PTDreamer/FrequencyCounter/docs/A Low Power, Low Cost, Differential Input to a Single-Ended Output Amplifier _ Analog Devices_files/raq-issue-145.jpg

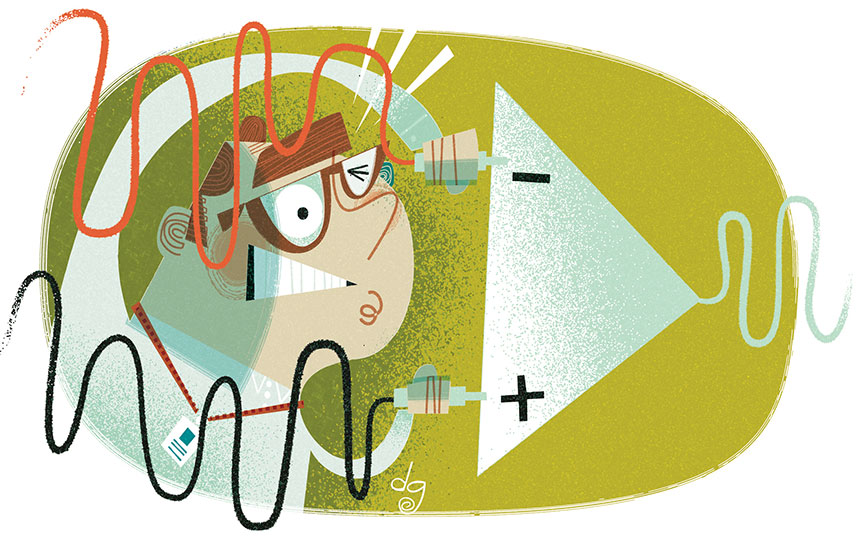
docs/A Low Power, Low Cost, Differential Input to a Single-Ended Output Amplifier _ Analog Devices_files/raq-issue-145.jpg
