PTDreamer/FrequencyCounter/docs/A Low Power, Low Cost, Differential Input to a Single-Ended Output Amplifier _ Analog Devices_files/jordyn-rombola.jpg

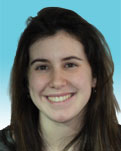
docs/A Low Power, Low Cost, Differential Input to a Single-Ended Output Amplifier _ Analog Devices_files/jordyn-rombola.jpg
