PTDreamer/FrequencyCounter/3D/0476Series_LTF.step

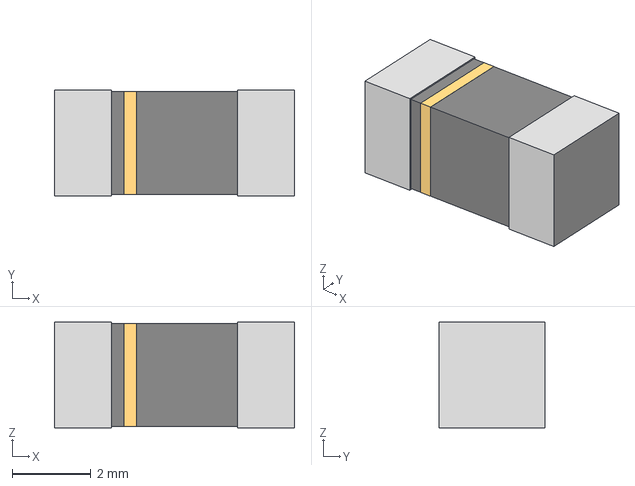
[picture p10: CAD file, 2021-09-11]
3D/0476Series_LTF.step
6.10 x 2.69 x 2.69 mm
