PTDreamer/FrequencyCounter/KiCAD_symbols3/eec.models/Analog_Devices_Inc_-_HMC624ALP4E.step

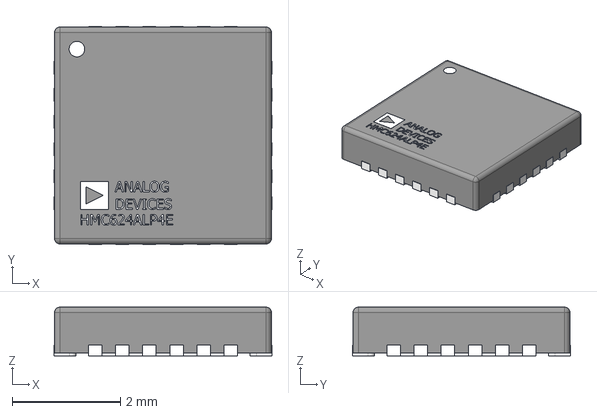
[picture p11: CAD file, 2021-09-11]
KiCAD_symbols3/eec.models/Analog_Devices_Inc_-_HMC624ALP4E.step
4.02 x 4.02 x 0.902 mm
