PTDreamer/FrequencyCounter/onsemi/eec.models/ON_Semiconductor_-_NC7SZ04M5X.step

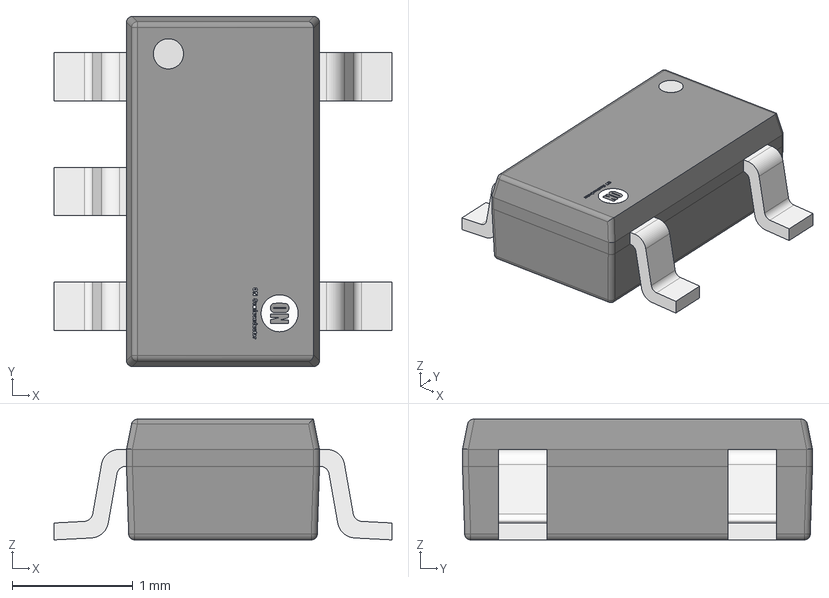
[picture p12: CAD file, 2021-09-11]
onsemi/eec.models/ON_Semiconductor_-_NC7SZ04M5X.step
2.80 x 2.90 x 1.00 mm
IC_BODY
IC_LEG x 5
circle
ON Semiconductor
