PTDreamer/FrequencyCounter/3D/SOT-223_5MC_MCH-L.step

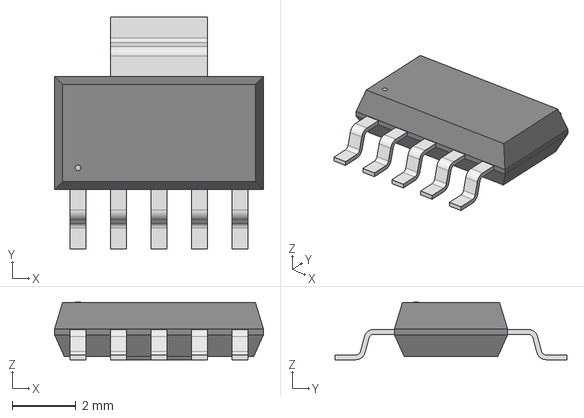
[picture p13: CAD file, 2021-09-11]
3D/SOT-223_5MC_MCH-L.step
6.55 x 7.26 x 1.80 mm
