PTDreamer/FrequencyCounter/3D/OCXO.step

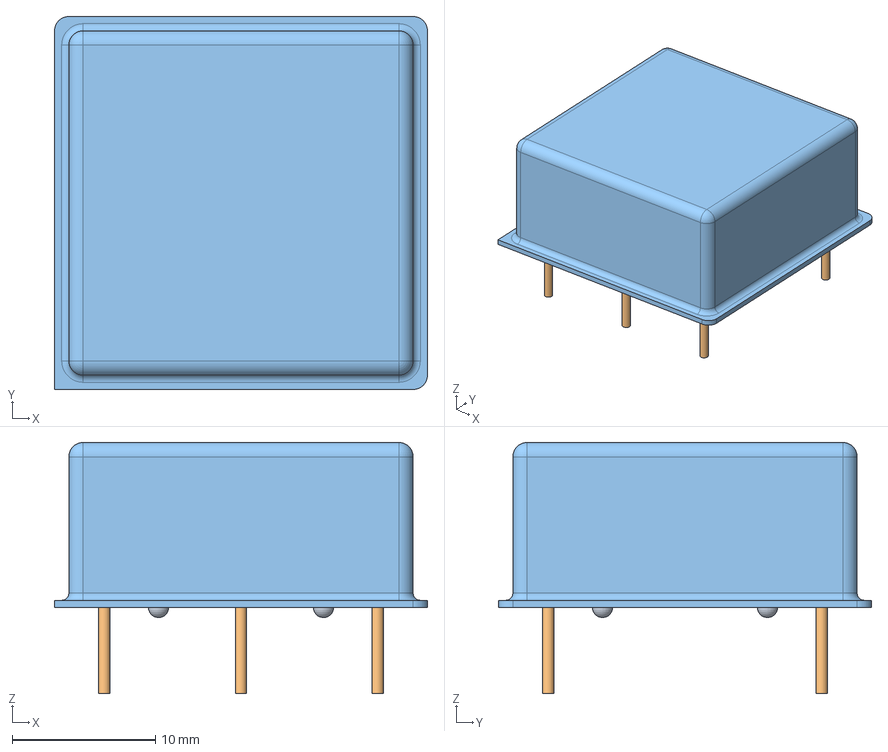
[picture p14: CAD file, 2021-09-11]
3D/OCXO.step
26.0 x 26.0 x 17.5 mm
