PTDreamer/FrequencyCounter/3D/ADL5385 in LFCSP 24 case.SLDPRT

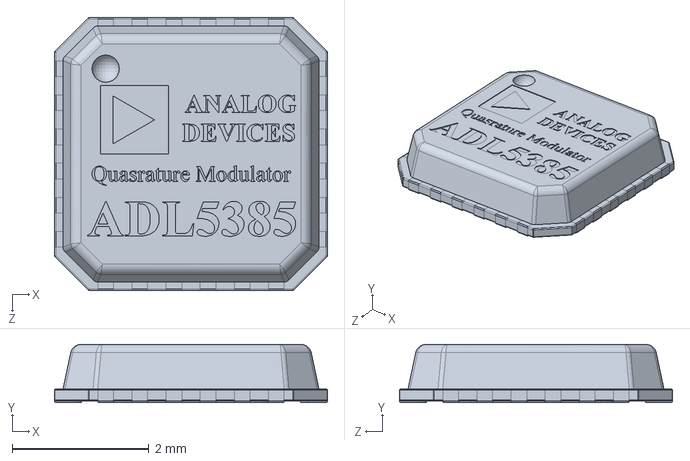
[picture p15: CAD file, 2021-09-11]
3D/ADL5385 in LFCSP 24 case.SLDPRT
4.00 x 0.85 x 4.00 mm
