PTDreamer/FrequencyCounter/3D/SMA_Board_Edge_Molex_732511150.step

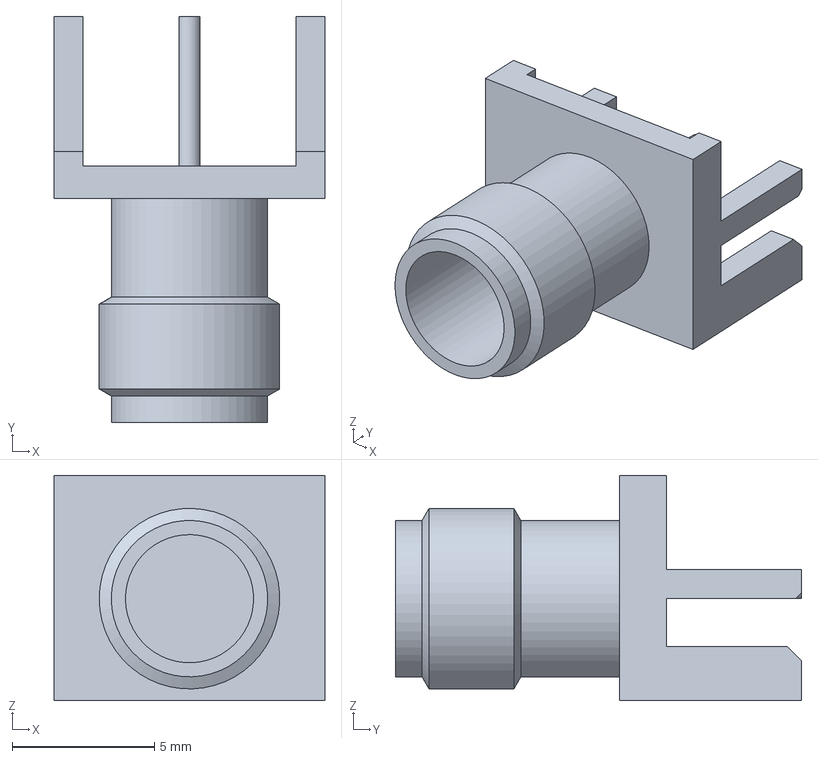
[picture p16: CAD file, 2021-09-11]
3D/SMA_Board_Edge_Molex_732511150.step
9.53 x 14.3 x 7.93 mm
