PTDreamer/FrequencyCounter/(list of files, cad)

Other CAD files:
3D/0476Series_LTF-M.step
3D/0476Series_LTF-L.step
3D/SOT-223_5MC_MCH-M.step
3D/SOT-223_5MC_MCH.step
3D/SMA_Board_Edge_Molex_732511150.fcstd
3D/SMA_Board_Edge_Molex_732511150.obj
3D/SMA_Board_Edge_Molex_732511150.stl
