PTDreamer/FrequencyCounter/docs/A Low Power, Low Cost, Differential Input to a Single-Ended Output Amplifier _ Analog Devices_files/raq-issue-145-fig-02.png

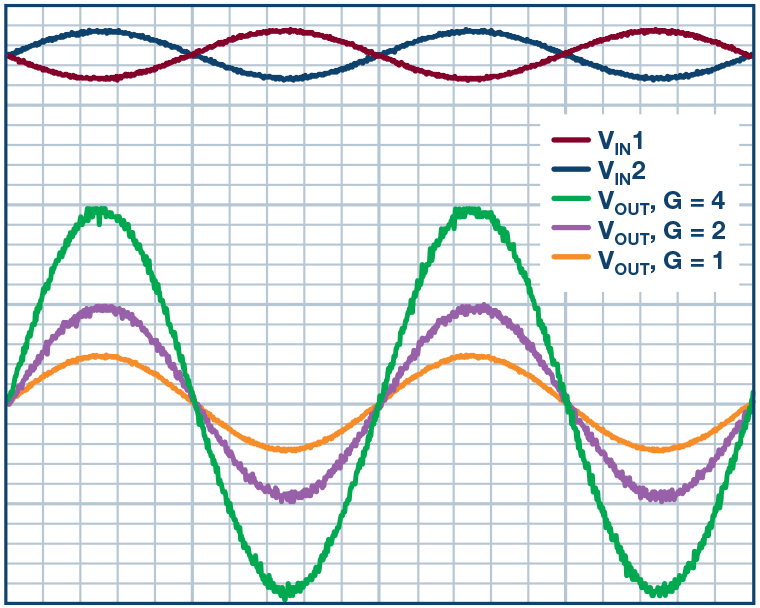
docs/A Low Power, Low Cost, Differential Input to a Single-Ended Output Amplifier _ Analog Devices_files/raq-issue-145-fig-02.png
