PTDreamer/FrequencyCounter/FrequencyCounter.kicad_pcb

## KiCad design FrequencyCounter.kicad_pcb (2021-09-11)

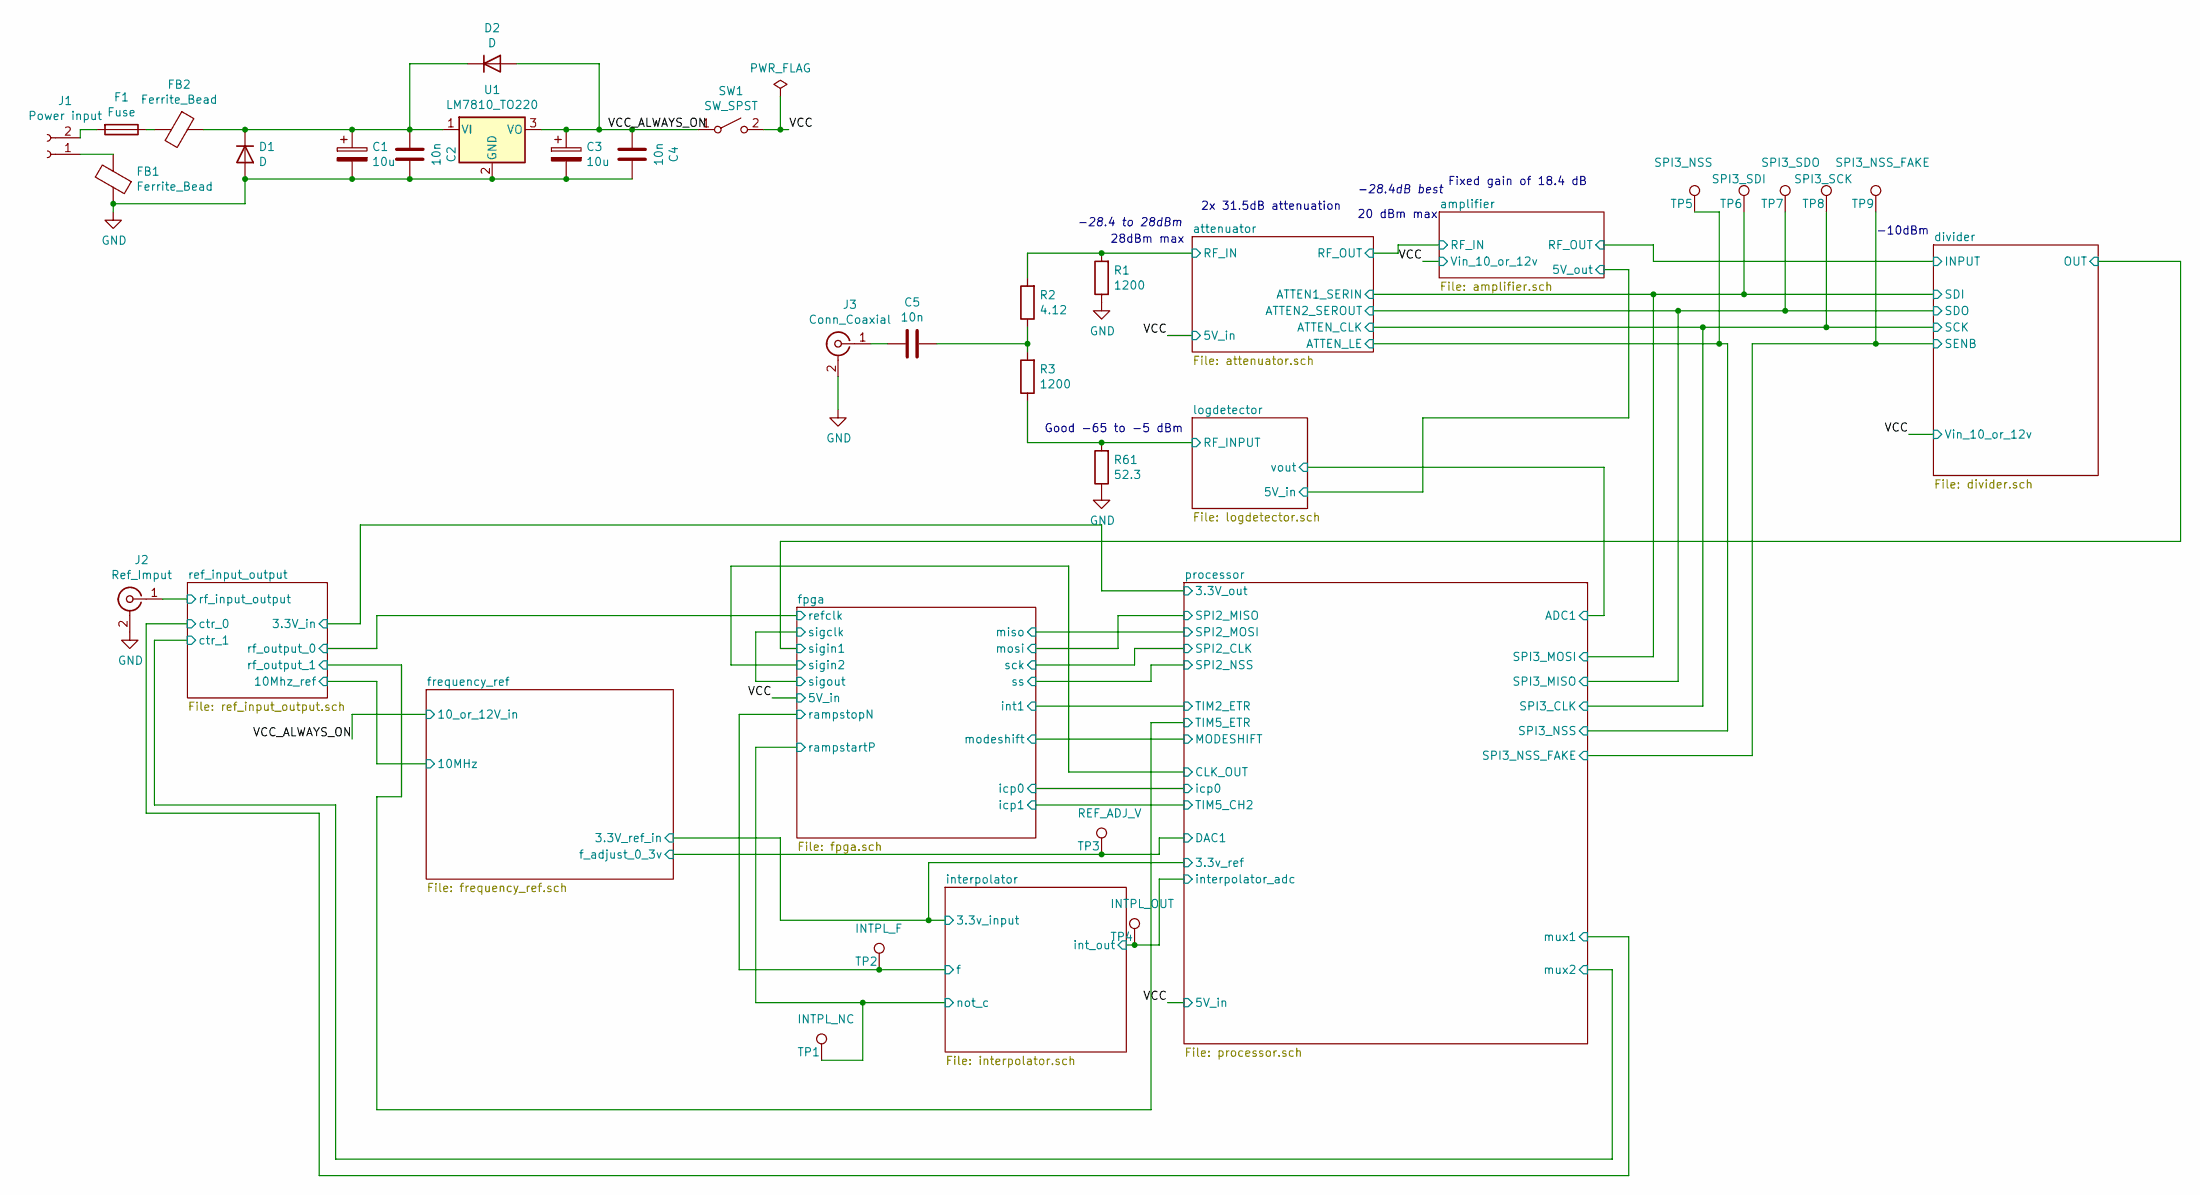
[picture p20: schematic FrequencyCounter.sch]

Parts:
C1, C3: 10u; CP_Radial_D5.0mm_P2.00mm
C2, C4: 10n; C_0805_2012Metric_Pad1.15x1.40mm_HandSolder
C5: 10n; C_0402_1005Metric
D1, D2: D; D_SOD-123
F1: Fuse; Fuseholder_Littelfuse_Nano2_157x
FB1, FB2: Ferrite_Bead; L_0805_2012Metric_Pad1.15x1.40mm_HandSolder
J1: Power input; PhoenixContact_MC_1,5_2-G-5.08_1x02_P5.08mm_Horizontal
J2: Ref_Imput; SMA_Amphenol_132289_EdgeMount
J3: Conn_Coaxial; SMA_Amphenol_132289_EdgeMount
R1, R3: 1200; R_0402_1005Metric
R2: 4.12; R_0402_1005Metric
R61: 52.3; R_0402_1005Metric
SW1: SW_SPST; PinSocket_1x02_P2.54mm_Vertical
TP1: INTPL_NC; TestPoint_Pad_D2.0mm
TP2: INTPL_F; TestPoint_Pad_D2.0mm
TP3: REF_ADJ_V; TestPoint_Pad_D2.0mm
TP4: INTPL_OUT; TestPoint_Pad_D2.0mm
TP5: SPI3_NSS; TestPoint_Pad_D2.0mm
TP6: SPI3_SDI; TestPoint_Pad_D2.0mm
TP7: SPI3_SDO; TestPoint_Pad_D2.0mm
TP8: SPI3_SCK; TestPoint_Pad_D2.0mm
TP9: SPI3_NSS_FAKE; TestPoint_Pad_D2.0mm
U1: LM7810_TO220; TO-220-3_Vertical

Connections:
/VCC: SW1.2 (B); also elsewhere on the board
/VCC_ALWAYS_ON: C3.1, C4.1, D2.2 (A), SW1.1 (A), U1.3 (VO); also elsewhere on the board
/attenuator/ATTEN1_SERIN: TP6.1; also elsewhere on the board
/attenuator/ATTEN2_SEROUT: TP7.1; also elsewhere on the board
/attenuator/ATTEN_CLK: TP8.1; also elsewhere on the board
/attenuator/ATTEN_LE: TP5.1; also elsewhere on the board
/attenuator/RF_IN: R1.2, R2.2; also elsewhere on the board
/divider/SENB: TP9.1; also elsewhere on the board
/interpolator/f: TP2.1; also elsewhere on the board
/interpolator/int_out: TP4.1; also elsewhere on the board
/interpolator/not_c: TP1.1; also elsewhere on the board
/logdetector/RF_INPUT: R3.1, R61.2; also elsewhere on the board
/processor/DAC1: TP3.1; also elsewhere on the board
/ref_input_output/rf_input_output: J2.1 (In); also elsewhere on the board
GND: C1.2, C2.2, C3.2, C4.2, D1.2 (A), FB1.1, J2.2 (Ext), J3.2 (Ext), R1.1, R61.1, U1.2 (GND); also elsewhere on the board
unnamed: C1.1, C2.1, D1.1 (K), D2.1 (K), FB2.1, U1.1 (VI)
unnamed: C5.1, J3.1 (In)
unnamed: C5.2, R2.1, R3.2
unnamed: F1.1, FB2.2
unnamed: F1.2, J1.2
unnamed: FB1.2, J1.1

Notes on the sheet:
28dBm max
20 dBm max
-10dBm
Good -65 to -5 dBm
2x 31.5dB attenuation
Fixed gain of 18.4 dB
-28.4dB best
-28.4 to 28dBm

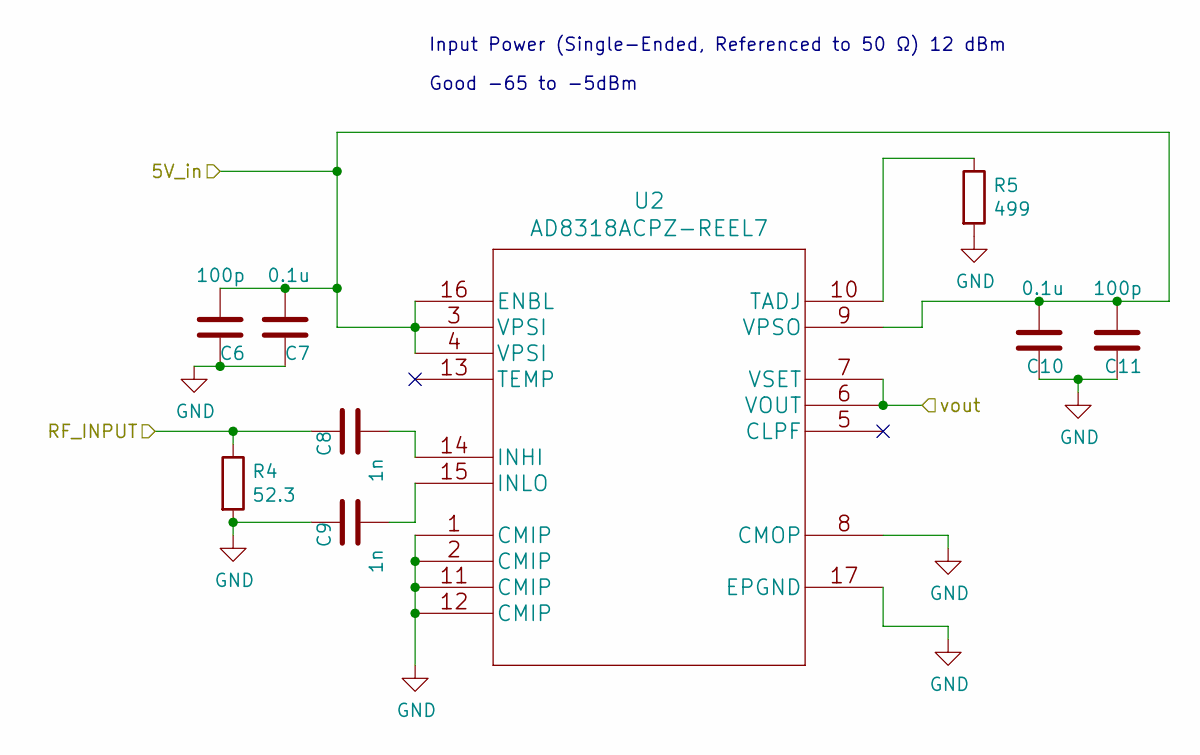
[picture p21: schematic logdetector.sch]

Parts:
C6, C11: 100p; C_0603_1608Metric_Pad1.05x0.95mm_HandSolder
C7, C10: 0.1u; C_0805_2012Metric_Pad1.15x1.40mm_HandSolder
C8, C9: 1n; C_0402_1005Metric
R4: 52.3; R_0402_1005Metric
R5: 499; R_0805_2012Metric_Pad1.15x1.40mm_HandSolder
U2: AD8318ACPZ-REEL7

Connections:
/logdetector/5V_in: C6.2, C7.2, C10.2, C11.2, U2.3 (VPSI), U2.4 (VPSI), U2.9 (VPSO), U2.16 (ENBL); also elsewhere on the board
/logdetector/RF_INPUT: C8.1, R4.1; also elsewhere on the board
/processor/ADC1: U2.6 (VOUT), U2.7 (VSET); also elsewhere on the board
GND: C6.1, C7.1, C9.1, C10.1, C11.1, R4.2, R5.2, U2.1 (CMIP), U2.2 (CMIP), U2.8 (CMOP), U2.11 (CMIP), U2.12 (CMIP), U2.17 (EPGND); also elsewhere on the board
unnamed: C8.2, U2.14 (INHI)
unnamed: C9.2, U2.15 (INLO)
unnamed: R5.1, U2.10 (TADJ)

Notes on the sheet:
Input Power (Single-Ended, Referenced to 50 Ω) 12 dBm
Good -65 to -5dBm

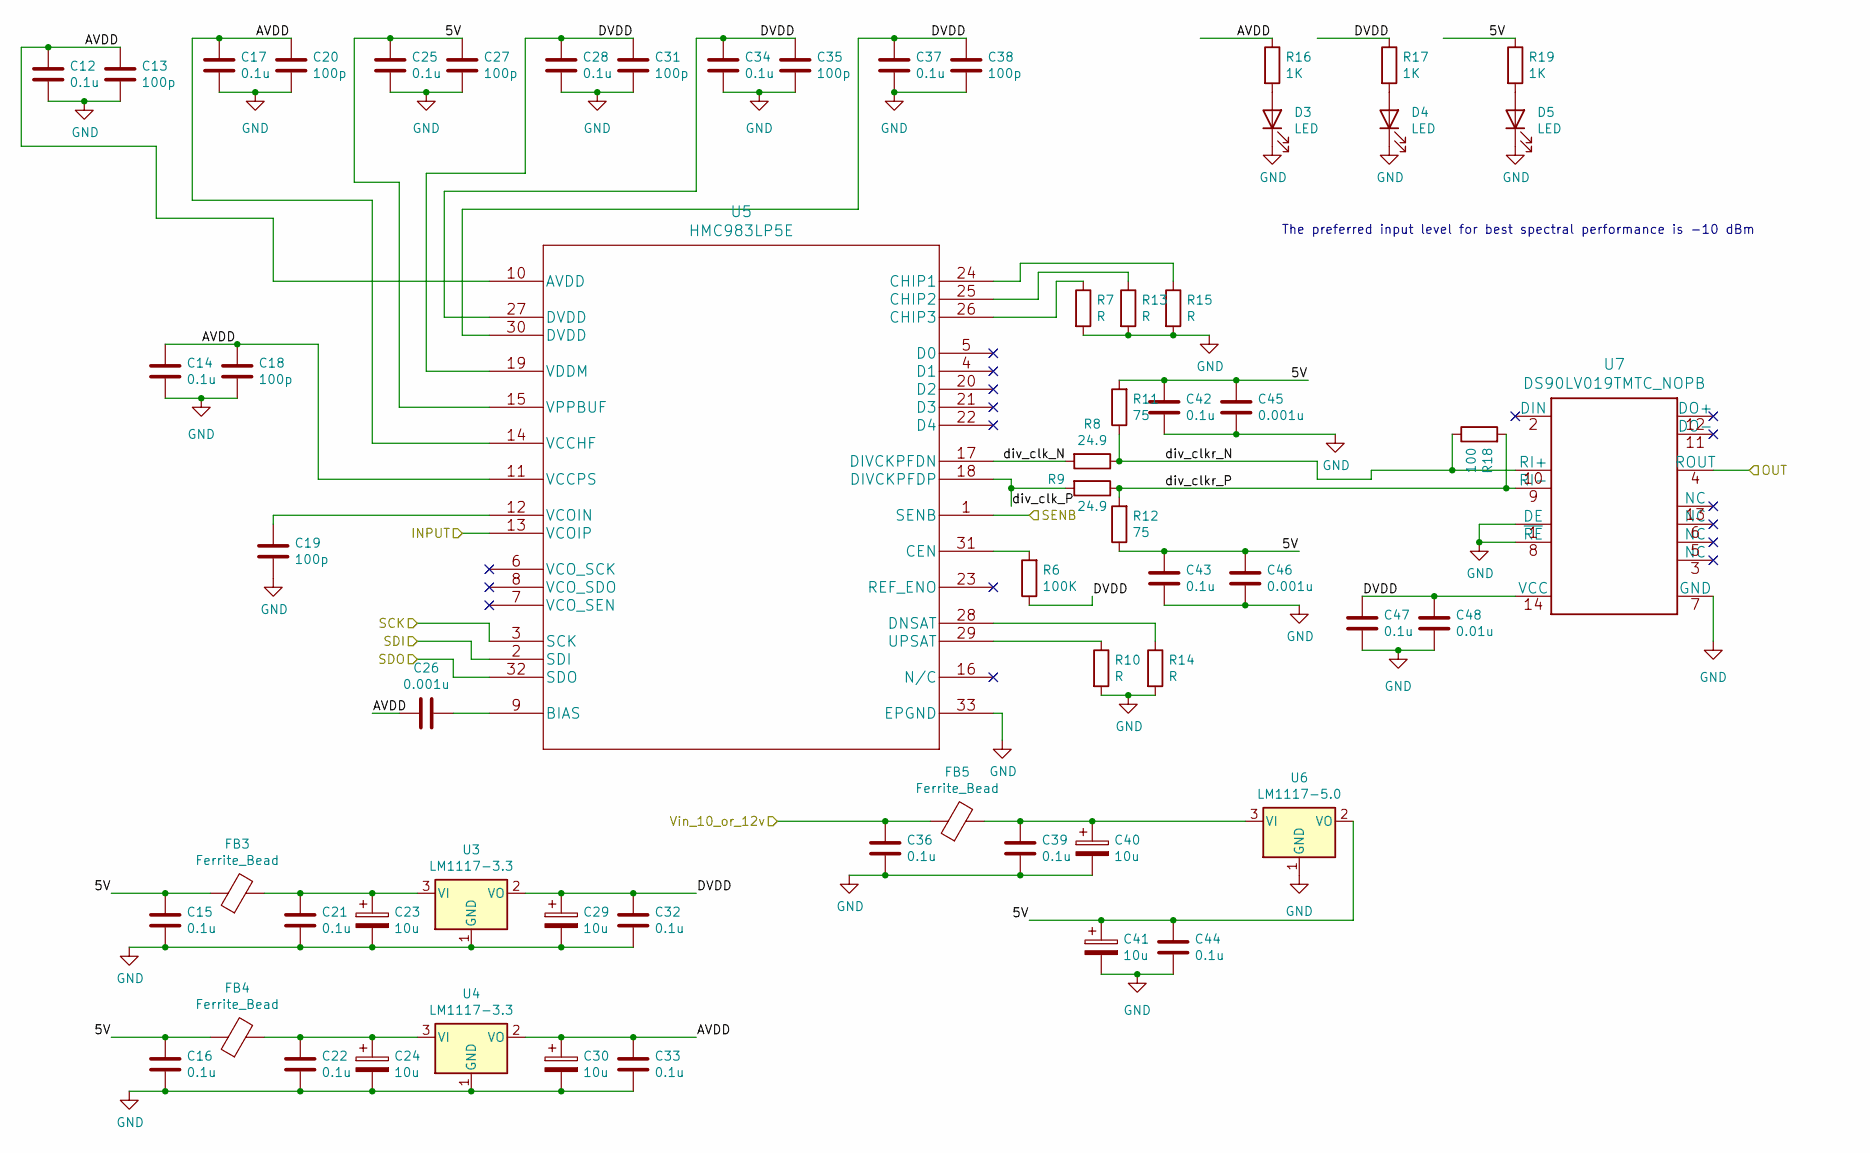
[picture p22: schematic divider.sch]

Parts:
C12, C14, C17, C25, C28, C34, C37, C42, C43, C47: 0.1u; C_0603_1608Metric_Pad1.05x0.95mm_HandSolder
C13, C18, C19, C20, C27, C31, C35, C38: 100p; C_0603_1608Metric_Pad1.05x0.95mm_HandSolder
C15, C16, C21, C22, C32, C33, C36, C39, C44: 0.1u; C_0805_2012Metric_Pad1.15x1.40mm_HandSolder
C23, C24, C29, C30, C40, C41: 10u; C_1206_3216Metric_Pad1.42x1.75mm_HandSolder
C26, C45, C46: 0.001u; C_0603_1608Metric_Pad1.05x0.95mm_HandSolder
C48: 0.01u; C_0603_1608Metric_Pad1.05x0.95mm_HandSolder
D3, D4, D5: LED; D_0805_2012Metric_Pad1.15x1.40mm_HandSolder
FB3, FB4, FB5: Ferrite_Bead; L_0805_2012Metric_Pad1.15x1.40mm_HandSolder
R6: 100K; R_0805_2012Metric_Pad1.15x1.40mm_HandSolder
R7, R10, R13, R14, R15: R; R_0805_2012Metric_Pad1.15x1.40mm_HandSolder
R8, R9: 24.9; R_0402_1005Metric
R11, R12: 75; R_0805_2012Metric_Pad1.15x1.40mm_HandSolder
R16, R17, R19: 1K; R_0805_2012Metric_Pad1.15x1.40mm_HandSolder
R18: 100; R_0805_2012Metric_Pad1.15x1.40mm_HandSolder
U3, U4: LM1117-3.3; SOT-223-3_TabPin2
U5: HMC983LP5E
U6: LM1117-5.0; SOT-223-3_TabPin2
U7: DS90LV019TMTC_NOPB; TSSOP-14_4.4x5mm_P0.65mm

Connections:
/VCC: C36.1, FB5.1; also elsewhere on the board
/attenuator/ATTEN1_SERIN: U5.2 (SDI); also elsewhere on the board
/attenuator/ATTEN2_SEROUT: U5.32 (SDO); also elsewhere on the board
/attenuator/ATTEN_CLK: U5.3 (SCK); also elsewhere on the board
/divider/5V: C15.1, C16.1, C25.1, C27.1, C41.1, C42.1, C43.1, C44.1, C45.1, C46.1, FB3.1, FB4.1, R11.2, R12.1, R19.1, U5.15 (VPPBUF), U6.2 (VO)
/divider/AVDD: C12.1, C13.1, C14.1, C17.1, C18.1, C20.1, C26.2, C30.1, C33.1, R16.1, U4.2 (VO), U5.10 (AVDD), U5.11 (VCCPS), U5.14 (VCCHF)
/divider/DVDD: C28.1, C29.1, C31.1, C32.1, C34.1, C35.1, C37.1, C38.1, C47.1, C48.1, R6.1, R17.1, U3.2 (VO), U5.19 (VDDM), U5.27 (DVDD), U5.30 (DVDD), U7.14 (VCC)
/divider/INPUT: U5.13 (VCOIP); also elsewhere on the board
/divider/OUT: U7.4 (ROUT); also elsewhere on the board
/divider/SENB: U5.1 (SENB); also elsewhere on the board
/divider/div_clk_N: R8.2, U5.17 (DIVCKPFDN)
/divider/div_clk_P: R9.2, U5.18 (DIVCKPFDP)
/divider/div_clkr_N: R8.1, R11.1, R18.1, U7.10 (RI+)
/divider/div_clkr_P: R9.1, R12.2, R18.2, U7.9 (RI-)
GND: C12.2, C13.2, C14.2, C15.2, C16.2, C17.2, C18.2, C19.2, C20.2, C21.2, C22.2, C23.2, C24.2, C25.2, C27.2, C28.2, C29.2, C30.2, C31.2, C32.2, C33.2, C34.2, C35.2, C36.2, C37.2, C38.2, C39.2, C40.2, C41.2, C42.2, C43.2, C44.2, C45.2, C46.2, C47.2, C48.2, D3.1 (K), D4.1 (K), D5.1 (K), R7.2, R10.2, R13.2, R14.2, R15.2, U3.1 (GND), U4.1 (GND), U5.33 (EPGND), U6.1 (GND), U7.1 (DE), U7.7 (GND), U7.8 (~RE); also elsewhere on the board
unnamed: C19.1, U5.12 (VCOIN)
unnamed: C21.1, C23.1, FB3.2, U3.3 (VI)
unnamed: C22.1, C24.1, FB4.2, U4.3 (VI)
unnamed: C26.1, U5.9 (BIAS)
unnamed: C39.1, C40.1, FB5.2, U6.3 (VI)
unnamed: D3.2 (A), R16.2
unnamed: D4.2 (A), R17.2
unnamed: D5.2 (A), R19.2
unnamed: R6.2, U5.31 (CEN)
unnamed: R7.1, U5.26 (CHIP3)
unnamed: R10.1, U5.29 (UPSAT)
unnamed: R13.1, U5.25 (CHIP2)
unnamed: R14.1, U5.28 (DNSAT)
unnamed: R15.1, U5.24 (CHIP1)

Notes on the sheet:
The preferred input level for best spectral performance is -10 dBm

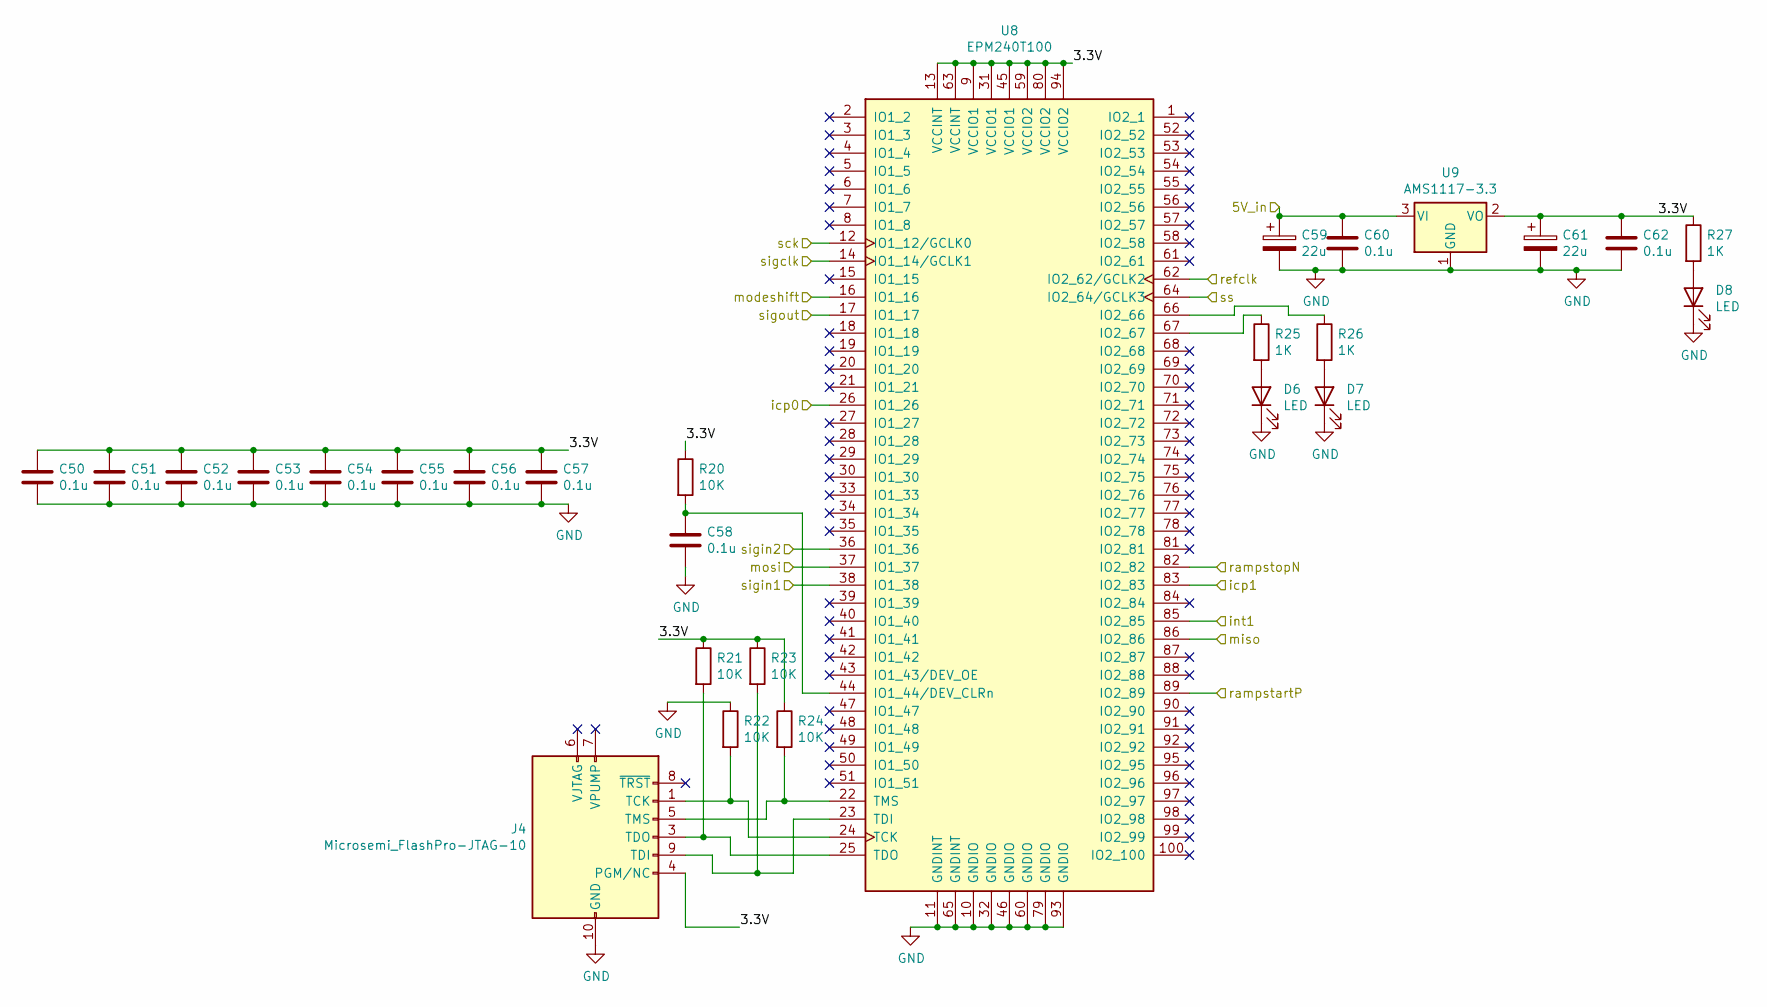
[picture p23: schematic fpga.sch]

Parts:
C50, C51, C52, C53, C54, C55, C56, C57, C58: 0.1u; C_0603_1608Metric_Pad1.05x0.95mm_HandSolder
C59, C61: 22u; C_1206_3216Metric_Pad1.42x1.75mm_HandSolder
C60, C62: 0.1u; C_0805_2012Metric_Pad1.15x1.40mm_HandSolder
D6, D7, D8: LED; D_0805_2012Metric_Pad1.15x1.40mm_HandSolder
J4: Microsemi_FlashPro-JTAG-10; IDC-Header_2x05_P2.54mm_Vertical
R20, R21, R22, R23, R24: 10K; R_0805_2012Metric_Pad1.15x1.40mm_HandSolder
R25, R26, R27: 1K; R_0805_2012Metric_Pad1.15x1.40mm_HandSolder
U8: EPM240T100; LQFP-100_14x14mm_P0.5mm
U9: AMS1117-3.3; SOT-223-3_TabPin2

Connections:
/VCC: C59.1, C60.1, U9.3 (VI); also elsewhere on the board
/divider/OUT: U8.38 (IO1_38); also elsewhere on the board
/fpga/3.3V: C50.1, C51.1, C52.1, C53.1, C54.1, C55.1, C56.1, C57.1, C61.1, C62.1, J4.4 (PGM/NC), R20.1, R21.1, R23.1, R24.1, R27.1, U8.9 (VCCIO1), U8.13 (VCCINT), U8.31 (VCCIO1), U8.45 (VCCIO1), U8.59 (VCCIO2), U8.63 (VCCINT), U8.80 (VCCIO2), U8.94 (VCCIO2), U9.2 (VO)
/fpga/icp0: U8.26 (IO1_26); also elsewhere on the board
/fpga/refclk: U8.62 (IO2_62/GCLK2); also elsewhere on the board
/fpga/sigclk: U8.14 (IO1_14/GCLK1), U8.17 (IO1_17)
/interpolator/f: U8.82 (IO2_82); also elsewhere on the board
/interpolator/not_c: U8.89 (IO2_89); also elsewhere on the board
/processor/CLK_OUT: U8.36 (IO1_36); also elsewhere on the board
/processor/MODESHIFT: U8.16 (IO1_16); also elsewhere on the board
/processor/SPI2_CLK: U8.12 (IO1_12/GCLK0); also elsewhere on the board
/processor/SPI2_MISO: U8.37 (IO1_37); also elsewhere on the board
/processor/SPI2_MOSI: U8.86 (IO2_86); also elsewhere on the board
/processor/SPI2_NSS: U8.64 (IO2_64/GCLK3); also elsewhere on the board
/processor/TIM2_ETR: U8.85 (IO2_85); also elsewhere on the board
/processor/TIM5_CH2: U8.83 (IO2_83); also elsewhere on the board
GND: C50.2, C51.2, C52.2, C53.2, C54.2, C55.2, C56.2, C57.2, C58.2, C59.2, C60.2, C61.2, C62.2, D6.1 (K), D7.1 (K), D8.1 (K), J4.2 (GND), J4.10 (GND), R22.1, U8.10 (GNDIO), U8.11 (GNDINT), U8.32 (GNDIO), U8.46 (GNDIO), U8.60 (GNDIO), U8.65 (GNDINT), U8.79 (GNDIO), U8.93 (GNDIO), U9.1 (GND); also elsewhere on the board
unnamed: C58.1, R20.2, U8.44 (IO1_44/DEV_CLRn)
unnamed: D6.2 (A), R25.2
unnamed: D7.2 (A), R26.2
unnamed: D8.2 (A), R27.2
unnamed: J4.1 (TCK), R22.2, U8.24 (TCK)
unnamed: J4.3 (TDO), R21.2, U8.25 (TDO)
unnamed: J4.5 (TMS), R24.2, U8.22 (TMS)
unnamed: J4.9 (TDI), R23.2, U8.23 (TDI)
unnamed: R25.1, U8.67 (IO2_67)
unnamed: R26.1, U8.66 (IO2_66)

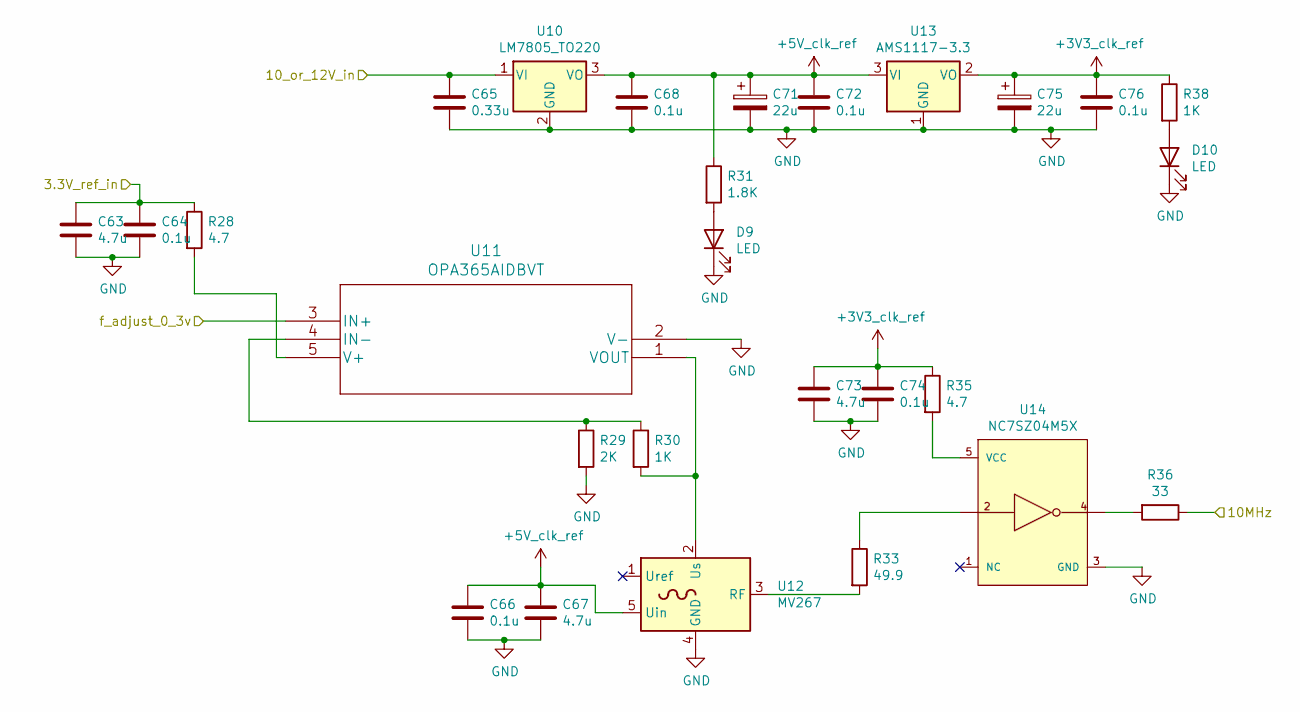
[picture p24: schematic frequency_ref.sch]

Parts:
C63, C67, C73: 4.7u; C_1206_3216Metric_Pad1.42x1.75mm_HandSolder
C64, C66, C68, C72, C74, C76: 0.1u; C_0805_2012Metric_Pad1.15x1.40mm_HandSolder
C65: 0.33u; C_1206_3216Metric_Pad1.42x1.75mm_HandSolder
C71, C75: 22u; C_1206_3216Metric_Pad1.42x1.75mm_HandSolder
D9, D10: LED; D_0805_2012Metric_Pad1.15x1.40mm_HandSolder
R28, R35: 4.7; R_0805_2012Metric_Pad1.15x1.40mm_HandSolder
R29: 2K; R_0805_2012Metric_Pad1.15x1.40mm_HandSolder
R30, R38: 1K; R_0805_2012Metric_Pad1.15x1.40mm_HandSolder
R31: 1.8K; R_0805_2012Metric_Pad1.15x1.40mm_HandSolder
R33: 49.9; R_0402_1005Metric
R36: 33; R_0402_1005Metric
U10: LM7805_TO220; TO-220-3_Vertical
U11: OPA365AIDBVT
U12: MV267; Oscillator_OCXO_Morion_MV317
U13: AMS1117-3.3; SOT-223-3_TabPin2
U14: NC7SZ04M5X; SOT-23-5_HandSoldering; mouser part number 512-NC7SZ04M5X; digikey description IC INVERTER 1CH 1-INP SOT23-5

Connections:
+3V3: C73.1, C74.1, C75.1, C76.1, R35.1, R38.1, U13.2 (VO)
+5V: C66.1, C67.1, C68.1, C71.1, C72.1, R31.1, U10.3 (VO), U12.5 (Uin), U13.3 (VI)
/VCC_ALWAYS_ON: C65.1, U10.1 (VI); also elsewhere on the board
/frequency_ref/3.3V_ref_in: C63.1, C64.1, R28.1; also elsewhere on the board
/frequency_ref/10MHz: R36.1; also elsewhere on the board
/processor/DAC1: U11.3 (IN+); also elsewhere on the board
GND: C63.2, C64.2, C65.2, C66.2, C67.2, C68.2, C71.2, C72.2, C73.2, C74.2, C75.2, C76.2, D9.1 (K), D10.1 (K), R29.2, U10.2 (GND), U11.2 (V-), U12.4 (GND), U13.1 (GND), U14.3 (GND); also elsewhere on the board
unnamed: D9.2 (A), R31.2
unnamed: D10.2 (A), R38.2
unnamed: R28.2, U11.5 (V+)
unnamed: R29.1, R30.1, U11.4 (IN-)
unnamed: R30.2, U11.1 (VOUT), U12.2 (Us)
unnamed: R33.1, U14.2 (A)
unnamed: R33.2, U12.3 (RF)
unnamed: R35.2, U14.5 (VCC)
unnamed: R36.2, U14.4 (Y)

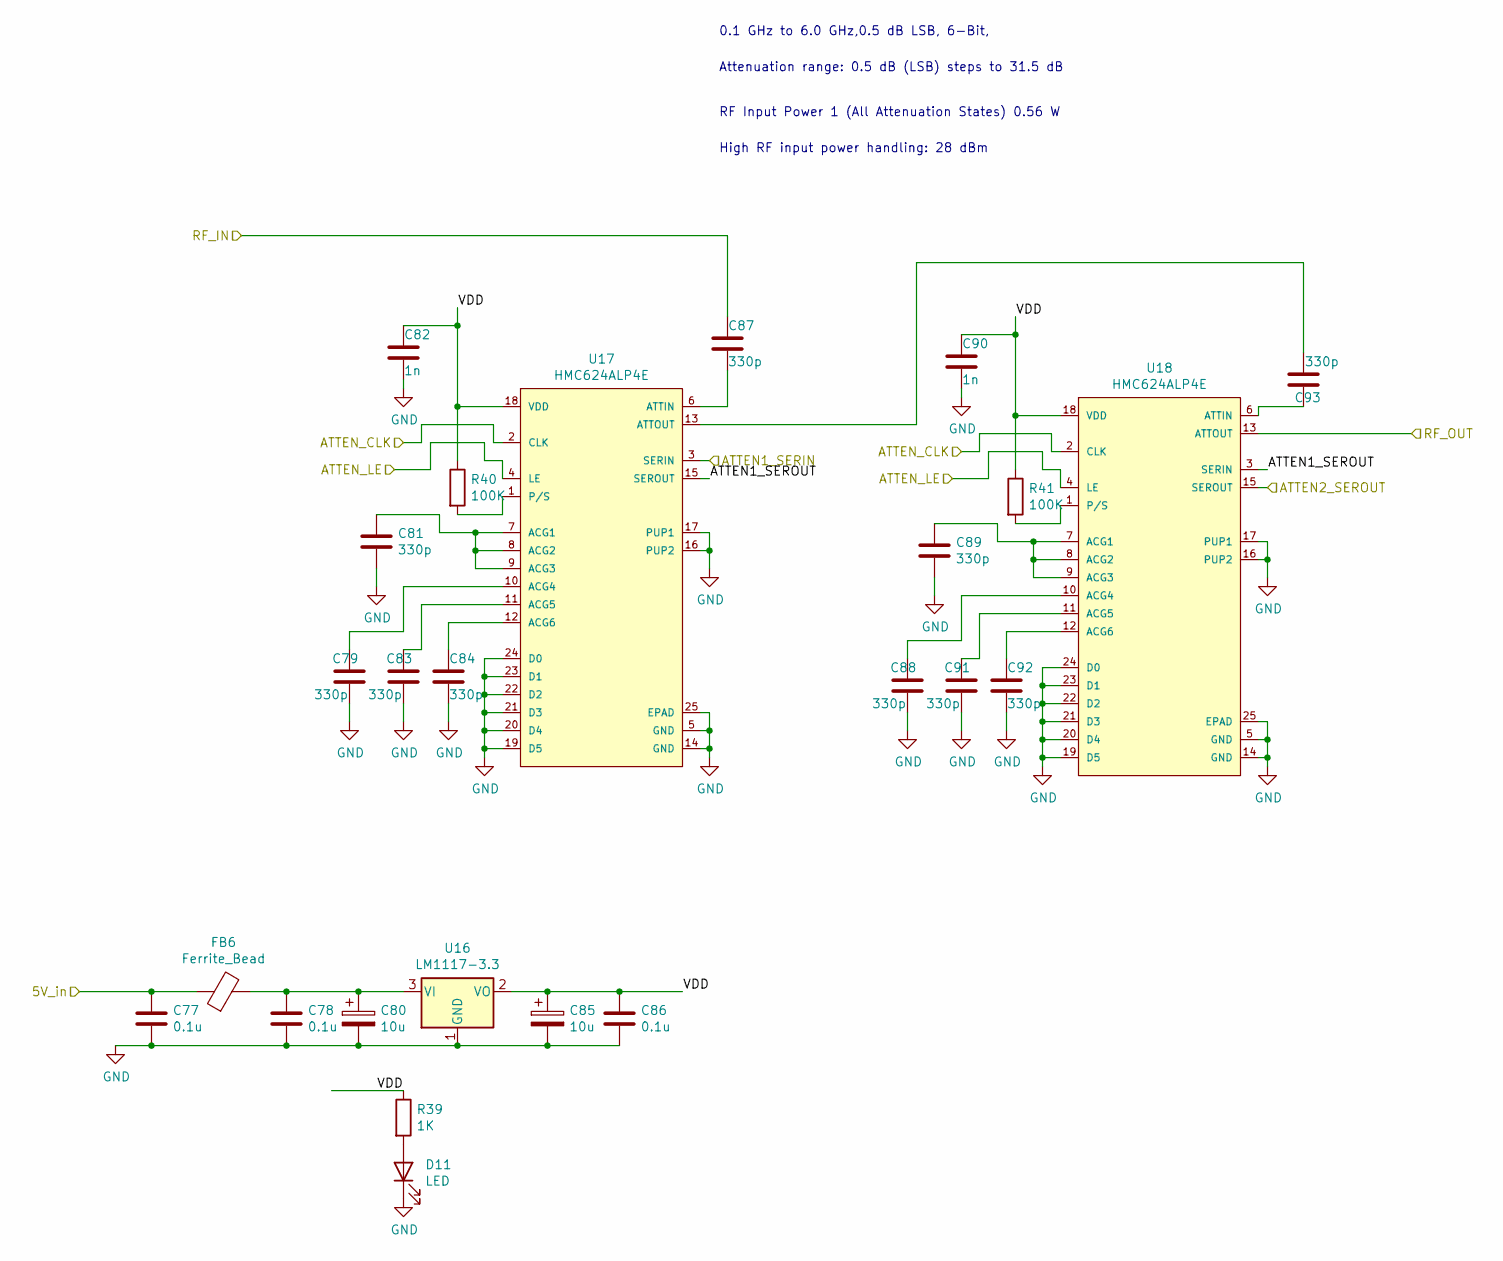
[picture p25: schematic attenuator.sch]

Parts:
C77, C78, C86: 0.1u; C_0805_2012Metric_Pad1.15x1.40mm_HandSolder
C79, C81, C83, C84, C88, C89, C91, C92: 330p; C_0603_1608Metric_Pad1.05x0.95mm_HandSolder
C80, C85: 10u; C_1206_3216Metric_Pad1.42x1.75mm_HandSolder
C82, C90: 1n; C_0603_1608Metric_Pad1.05x0.95mm_HandSolder
C87, C93: 330p; C_0402_1005Metric
D11: LED; D_0805_2012Metric_Pad1.15x1.40mm_HandSolder
FB6: Ferrite_Bead; L_0805_2012Metric_Pad1.15x1.40mm_HandSolder
R39: 1K; R_0805_2012Metric_Pad1.15x1.40mm_HandSolder
R40, R41: 100K; R_0805_2012Metric_Pad1.15x1.40mm_HandSolder
U16: LM1117-3.3; SOT-223-3_TabPin2
U17, U18: HMC624ALP4E; Analog_Devices_Inc-CP-24-16-12_2017-C-0; mouser part number 584-HMC624ALP4E; digikey description RF ATTENUATOR 31.5DB 50OHM 24QFN

Connections:
/VCC: C77.1, FB6.1; also elsewhere on the board
/amplifier/RF_IN: U18.13 (ATTOUT); also elsewhere on the board
/attenuator/ATTEN1_SERIN: U17.3 (SERIN); also elsewhere on the board
/attenuator/ATTEN1_SEROUT: U17.15 (SEROUT), U18.3 (SERIN)
/attenuator/ATTEN2_SEROUT: U18.15 (SEROUT); also elsewhere on the board
/attenuator/ATTEN_CLK: U17.2 (CLK), U18.2 (CLK); also elsewhere on the board
/attenuator/ATTEN_LE: U17.4 (LE), U18.4 (LE); also elsewhere on the board
/attenuator/RF_IN: C87.1; also elsewhere on the board
/attenuator/VDD: C82.1, C85.1, C86.1, C90.1, R39.1, R40.1, R41.1, U16.2 (VO), U17.18 (VDD), U18.18 (VDD)
GND: C77.2, C78.2, C79.2, C80.2, C81.2, C82.2, C83.2, C84.2, C85.2, C86.2, C88.2, C89.2, C90.2, C91.2, C92.2, D11.1 (K), U16.1 (GND), U17.5 (GND), U17.14 (GND), U17.16 (PUP2), U17.17 (PUP1), U17.19 (D5), U17.20 (D4), U17.21 (D3), U17.22 (D2), U17.23 (D1), U17.24 (D0), U17.25 (EPAD), U18.5 (GND), U18.14 (GND), U18.16 (PUP2), U18.17 (PUP1), U18.19 (D5), U18.20 (D4), U18.21 (D3), U18.22 (D2), U18.23 (D1), U18.24 (D0), U18.25 (EPAD); also elsewhere on the board
unnamed: C78.1, C80.1, FB6.2, U16.3 (VI)
unnamed: C79.1, U17.10 (ACG4)
unnamed: C81.1, U17.7 (ACG1), U17.8 (ACG2), U17.9 (ACG3)
unnamed: C83.1, U17.11 (ACG5)
unnamed: C84.1, U17.12 (ACG6)
unnamed: C87.2, U17.6 (ATTIN)
unnamed: C88.1, U18.10 (ACG4)
unnamed: C89.1, U18.7 (ACG1), U18.8 (ACG2), U18.9 (ACG3)
unnamed: C91.1, U18.11 (ACG5)
unnamed: C92.1, U18.12 (ACG6)
unnamed: C93.1, U18.6 (ATTIN)
unnamed: C93.2, U17.13 (ATTOUT)
unnamed: D11.2 (A), R39.2
unnamed: R40.2, U17.1 (P/S)
unnamed: R41.2, U18.1 (P/S)

Notes on the sheet:
0.1 GHz to 6.0 GHz,0.5 dB LSB, 6-Bit,
Attenuation range: 0.5 dB (LSB) steps to 31.5 dB
RF Input Power 1 (All Attenuation States) 0.56 W
High RF input power handling: 28 dBm

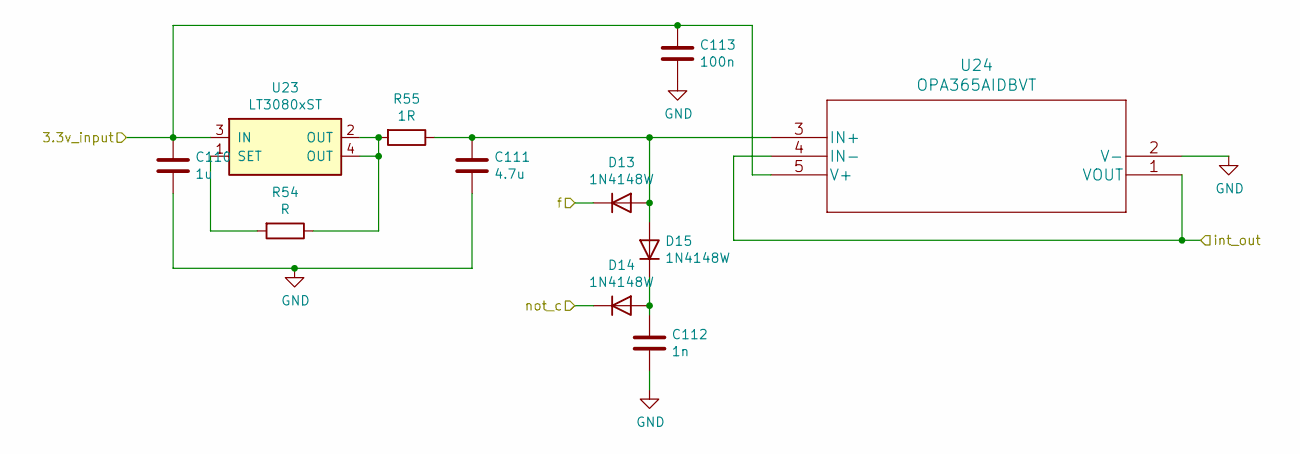
[picture p26: schematic interpolator.sch]

Parts:
C110: 1u; C_0805_2012Metric_Pad1.15x1.40mm_HandSolder
C111: 4.7u; C_1206_3216Metric_Pad1.42x1.75mm_HandSolder
C112: 1n; C_0805_2012Metric_Pad1.15x1.40mm_HandSolder
C113: 100n; C_0805_2012Metric_Pad1.15x1.40mm_HandSolder
D13, D14, D15: 1N4148W; D_SOD-123
R54: R; R_0805_2012Metric_Pad1.15x1.40mm_HandSolder
R55: 1R; R_0805_2012Metric_Pad1.15x1.40mm_HandSolder
U23: LT3080xST; SOT-223
U24: OPA365AIDBVT

Connections:
/frequency_ref/3.3V_ref_in: C110.1, C113.1, U23.3 (IN), U24.5 (V+); also elsewhere on the board
/interpolator/f: D13.1 (K); also elsewhere on the board
/interpolator/int_out: U24.1 (VOUT), U24.4 (IN-); also elsewhere on the board
/interpolator/not_c: D14.1 (K); also elsewhere on the board
GND: C110.2, C111.2, C112.2, C113.2, U24.2 (V-); also elsewhere on the board
unnamed: C111.1, D13.2 (A), D15.2 (A), R55.1, U24.3 (IN+)
unnamed: C112.1, D14.2 (A), D15.1 (K)
unnamed: R54.1, R55.2, U23.2 (OUT), U23.4 (OUT)
unnamed: R54.2, U23.1 (SET)

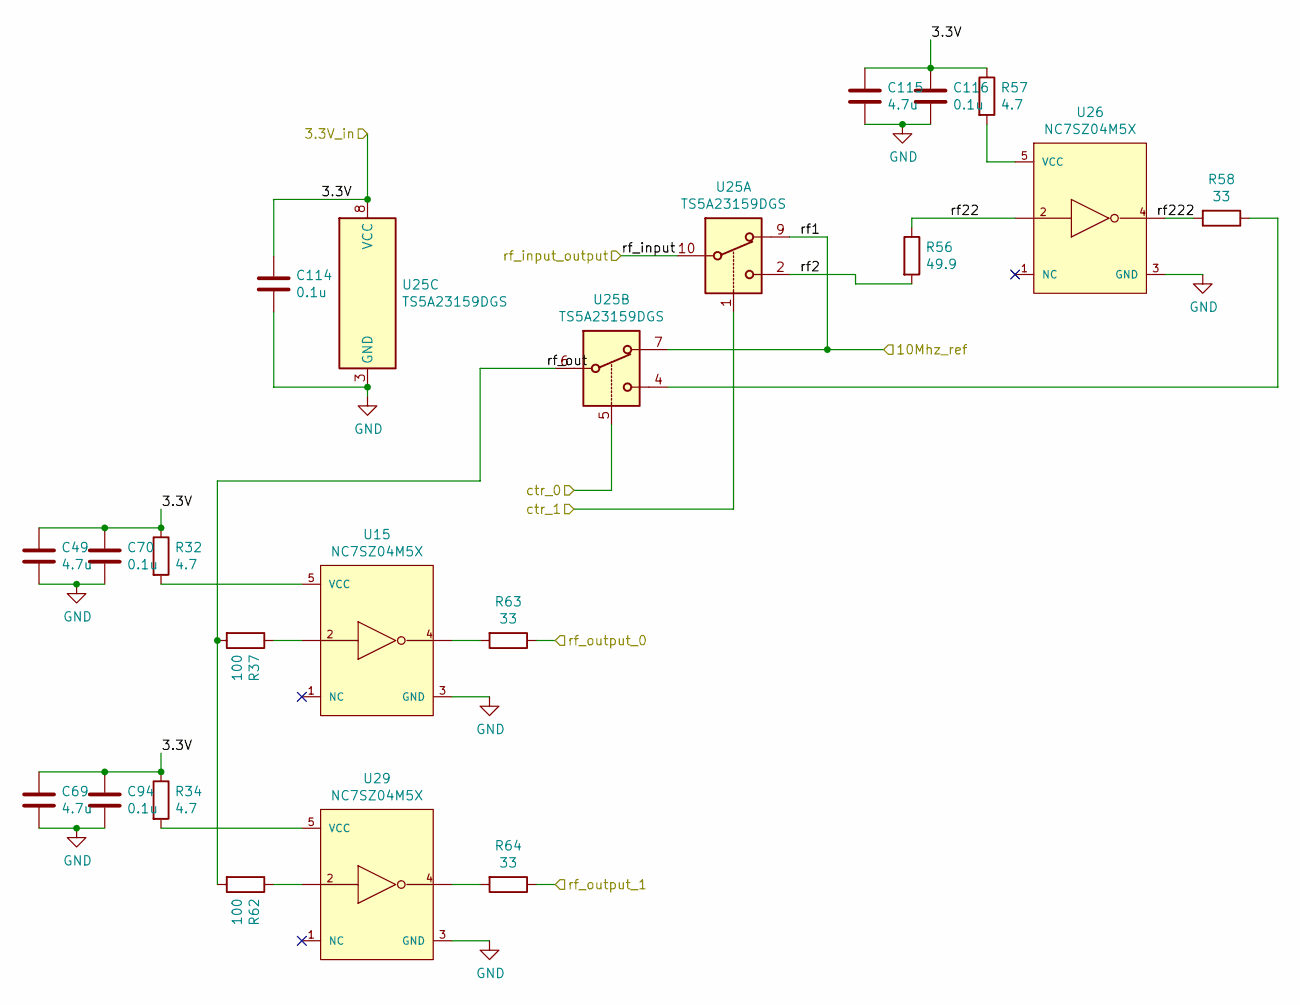
[picture p27: schematic ref_input_output.sch]

Parts:
C49, C69, C115: 4.7u; C_1206_3216Metric_Pad1.42x1.75mm_HandSolder
C70, C94, C114, C116: 0.1u; C_0805_2012Metric_Pad1.15x1.40mm_HandSolder
R32, R34, R57: 4.7; R_0805_2012Metric_Pad1.15x1.40mm_HandSolder
R37, R62: 100; R_0402_1005Metric
R56: 49.9; R_0402_1005Metric
R58, R63, R64: 33; R_0402_1005Metric
U15, U26, U29: NC7SZ04M5X; SOT-23-5_HandSoldering; mouser part number 512-NC7SZ04M5X; digikey description IC INVERTER 1CH 1-INP SOT23-5
U25: TS5A23159DGS; VSSOP-10_3x3mm_P0.5mm

Connections:
+3V3_processor: C49.1, C69.1, C70.1, C94.1, C114.1, C115.1, C116.1, R32.1, R34.1, R57.1, U25.8 (VCC); also elsewhere on the board
/fpga/refclk: R63.1; also elsewhere on the board
/frequency_ref/10MHz: U25.7, U25.9; also elsewhere on the board
/processor/TIM5_ETR: R64.1; also elsewhere on the board
/ref_input_output/ctr_0: U25.5; also elsewhere on the board
/ref_input_output/ctr_1: U25.1; also elsewhere on the board
/ref_input_output/rf2: R56.2, U25.2
/ref_input_output/rf22: R56.1, U26.2 (A)
/ref_input_output/rf_input_output: U25.10; also elsewhere on the board
/ref_input_output/rf_out: R37.2, R62.2, U25.6
GND: C49.2, C69.2, C70.2, C94.2, C114.2, C115.2, C116.2, U15.3 (GND), U25.3 (GND), U26.3 (GND), U29.3 (GND); also elsewhere on the board
unnamed: R32.2, U15.5 (VCC)
unnamed: R34.2, U29.5 (VCC)
unnamed: R37.1, U15.2 (A)
unnamed: R57.2, U26.5 (VCC)
unnamed: R58.1, U25.4
unnamed: R58.2, U26.4 (Y)
unnamed: R62.1, U29.2 (A)
unnamed: R63.2, U15.4 (Y)
unnamed: R64.2, U29.4 (Y)
