PTDreamer/FrequencyCounter/FrequencyCounter.kicad_pcb

## KiCad design FrequencyCounter.kicad_pcb (continued)

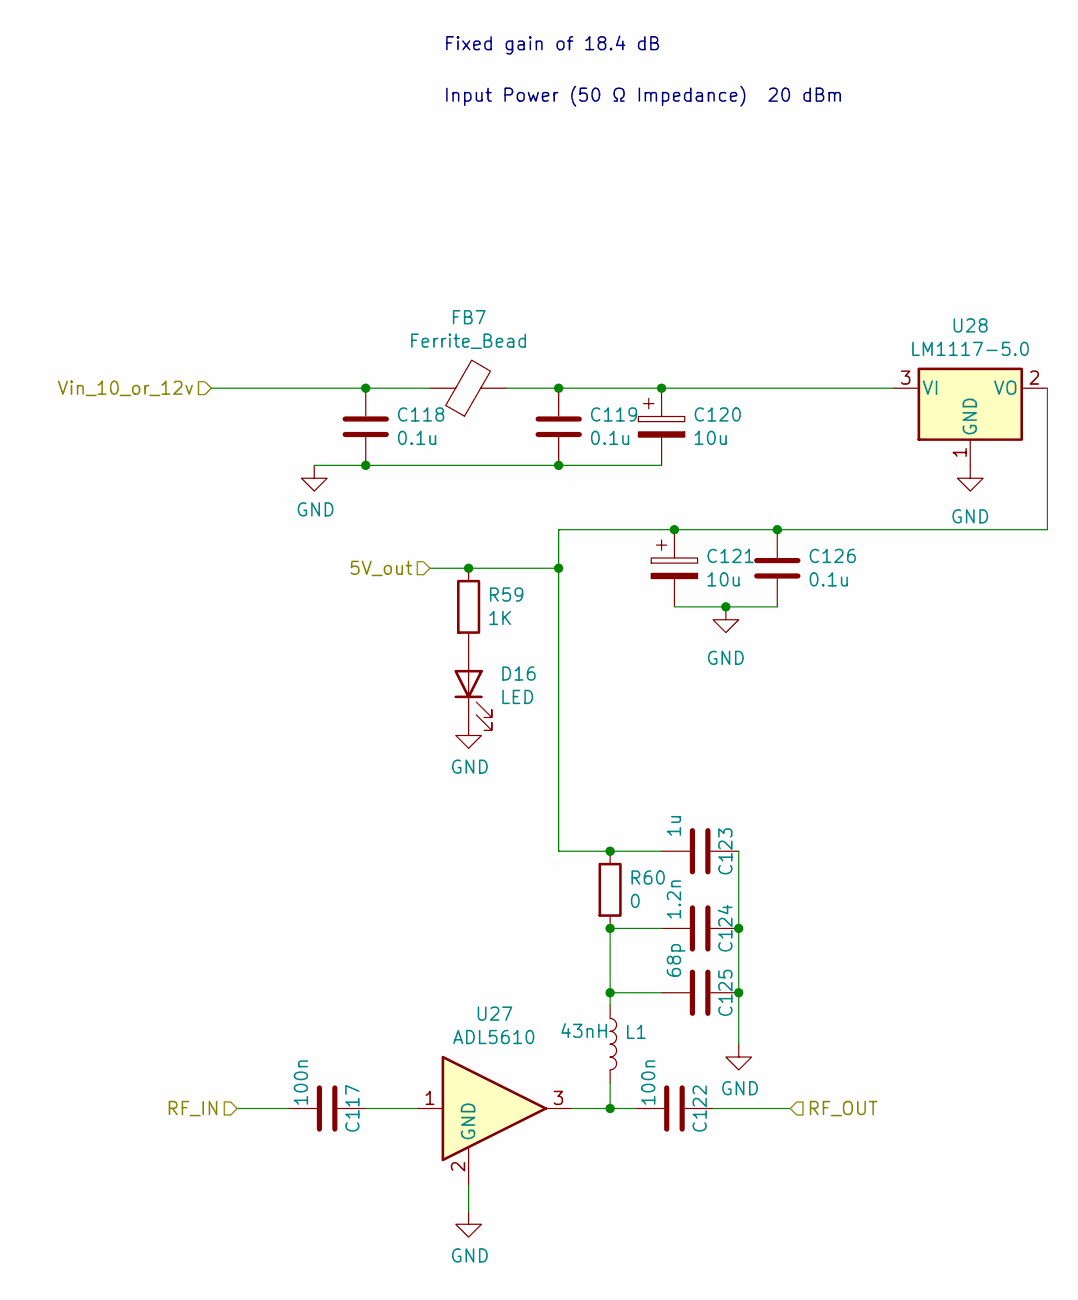
[picture p28: schematic amplifier.sch]

Parts:
C117, C122: 100n; C_0402_1005Metric
C118, C119, C126: 0.1u; C_0805_2012Metric_Pad1.15x1.40mm_HandSolder
C120, C121: 10u; C_1206_3216Metric_Pad1.42x1.75mm_HandSolder
C123: 1u; C_0805_2012Metric_Pad1.15x1.40mm_HandSolder
C124: 1.2n; C_0805_2012Metric_Pad1.15x1.40mm_HandSolder
C125: 68p; C_0603_1608Metric_Pad1.05x0.95mm_HandSolder
D16: LED; D_0805_2012Metric_Pad1.15x1.40mm_HandSolder
FB7: Ferrite_Bead; L_0805_2012Metric_Pad1.15x1.40mm_HandSolder
L1: 43nH; L_0805_2012Metric_Pad1.15x1.40mm_HandSolder
R59: 1K; R_0805_2012Metric_Pad1.15x1.40mm_HandSolder
R60: 0; R_0805_2012Metric_Pad1.15x1.40mm_HandSolder
U27: ADL5610; SOT-89-3
U28: LM1117-5.0; SOT-223-3_TabPin2

Connections:
/VCC: C118.1, FB7.1; also elsewhere on the board
/amplifier/RF_IN: C117.2; also elsewhere on the board
/divider/INPUT: C122.1; also elsewhere on the board
/logdetector/5V_in: C121.1, C123.2, C126.1, R59.1, R60.1, U28.2 (VO); also elsewhere on the board
GND: C118.2, C119.2, C120.2, C121.2, C123.1, C124.1, C125.1, C126.2, D16.1 (K), U27.2 (GND), U28.1 (GND); also elsewhere on the board
unnamed: C117.1, U27.1
unnamed: C119.1, C120.1, FB7.2, U28.3 (VI)
unnamed: C122.2, L1.2, U27.3
unnamed: C124.2, C125.2, L1.1, R60.2
unnamed: D16.2 (A), R59.2

Notes on the sheet:
Fixed gain of 18.4 dB
Input Power (50 Ω Impedance) 20 dBm

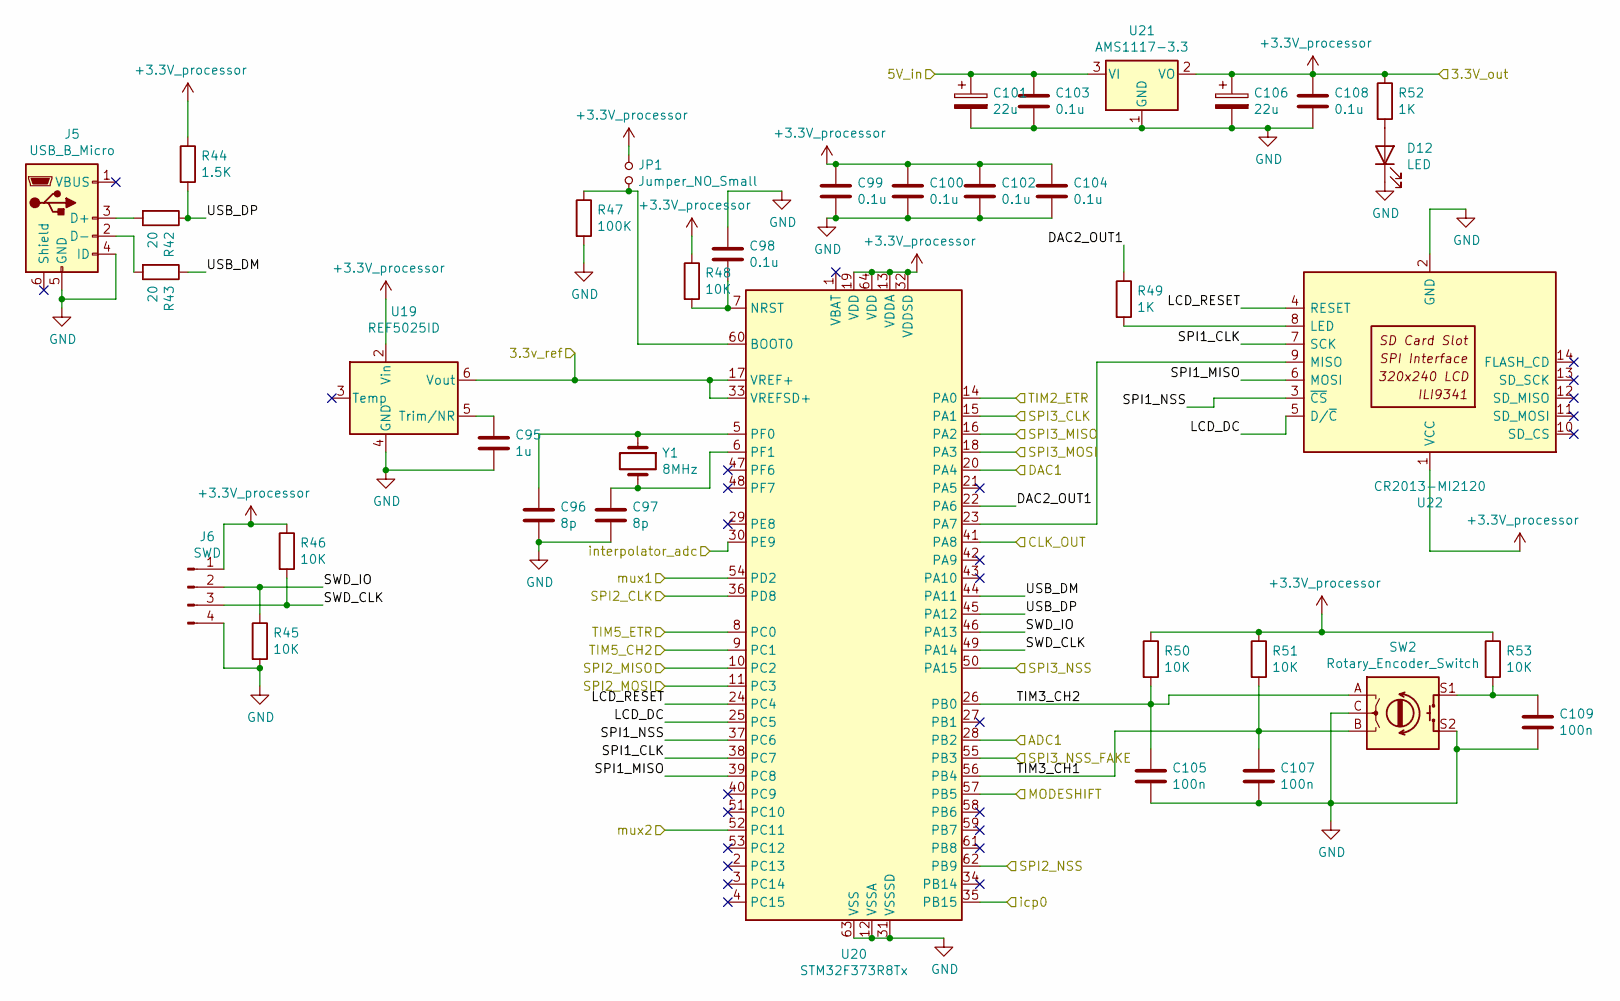
[picture p29: schematic processor.sch]

Parts:
C95: 1u; C_0805_2012Metric_Pad1.15x1.40mm_HandSolder
C96, C97: 8p; C_0603_1608Metric_Pad1.05x0.95mm_HandSolder
C98, C99, C100, C102, C103, C104, C108: 0.1u; C_0805_2012Metric_Pad1.15x1.40mm_HandSolder
C101, C106: 22u; C_1206_3216Metric_Pad1.42x1.75mm_HandSolder
C105, C107, C109: 100n; C_0805_2012Metric_Pad1.15x1.40mm_HandSolder
D12: LED; D_0805_2012Metric_Pad1.15x1.40mm_HandSolder
J5: USB_B_Micro; USB_Mini-B_Wuerth_65100516121_Horizontal
J6: SWD; PinHeader_1x04_P1.27mm_Vertical
JP1: Jumper_NO_Small; PinHeader_1x02_P1.27mm_Vertical
R42, R43: 20; R_0805_2012Metric_Pad1.15x1.40mm_HandSolder
R44: 1.5K; R_0805_2012Metric_Pad1.15x1.40mm_HandSolder
R45, R46, R48, R50, R51, R53: 10K; R_0805_2012Metric_Pad1.15x1.40mm_HandSolder
R47: 100K; R_0805_2012Metric_Pad1.15x1.40mm_HandSolder
R49, R52: 1K; R_0805_2012Metric_Pad1.15x1.40mm_HandSolder
SW2: Rotary_Encoder_Switch; 1x5_1.27_rotary_encoder
U19: REF5025ID; SOIC-8_3.9x4.9mm_P1.27mm
U20: STM32F373R8Tx; LQFP-64_10x10mm_P0.5mm
U21: AMS1117-3.3; SOT-223-3_TabPin2
U22: CR2013-MI2120; PinHeader_2x07_P1.27mm_Vertical
Y1: 8MHz; Crystal_SMD_5032-2Pin_5.0x3.2mm_HandSoldering

Connections:
+3V3_processor: C99.1, C100.1, C102.1, C104.1, C106.1, C108.1, J6.1, JP1.1, R44.1, R46.1, R48.1, R50.1, R51.1, R52.1, R53.1, U19.2 (Vin), U20.13 (VDDA), U20.19 (VDD), U20.32 (VDDSD), U20.64 (VDD), U21.2 (VO), U22.1 (VCC); also elsewhere on the board
/VCC: C101.1, C103.1, U21.3 (VI); also elsewhere on the board
/attenuator/ATTEN1_SERIN: U20.18 (PA3); also elsewhere on the board
/attenuator/ATTEN2_SEROUT: U20.16 (PA2); also elsewhere on the board
/attenuator/ATTEN_CLK: U20.15 (PA1); also elsewhere on the board
/attenuator/ATTEN_LE: U20.50 (PA15); also elsewhere on the board
/divider/SENB: U20.55 (PB3); also elsewhere on the board
/fpga/icp0: U20.35 (PB15); also elsewhere on the board
/frequency_ref/3.3V_ref_in: U19.6 (Vout), U20.17 (VREF+), U20.33 (VREFSD+); also elsewhere on the board
/interpolator/int_out: U20.30 (PE9); also elsewhere on the board
/processor/ADC1: U20.28 (PB2); also elsewhere on the board
/processor/CLK_OUT: U20.41 (PA8); also elsewhere on the board
/processor/DAC1: U20.20 (PA4); also elsewhere on the board
/processor/DAC2_OUT1: R49.1, U20.22 (PA6)
/processor/LCD_DC: U20.25 (PC5), U22.5 (D/~C)
/processor/LCD_RESET: U20.24 (PC4), U22.4 (RESET)
/processor/MODESHIFT: U20.57 (PB5); also elsewhere on the board
/processor/SPI1_CLK: U20.38 (PC7), U22.7 (SCK)
/processor/SPI1_MISO: U20.39 (PC8), U22.6 (MOSI)
/processor/SPI1_NSS: U20.37 (PC6), U22.3 (~CS)
/processor/SPI2_CLK: U20.36 (PD8); also elsewhere on the board
/processor/SPI2_MISO: U20.10 (PC2); also elsewhere on the board
/processor/SPI2_MOSI: U20.11 (PC3); also elsewhere on the board
/processor/SPI2_NSS: U20.62 (PB9); also elsewhere on the board
/processor/SWD_CLK: J6.3, R46.2, U20.49 (PA14)
/processor/SWD_IO: J6.2, R45.1, U20.46 (PA13)
/processor/TIM2_ETR: U20.14 (PA0); also elsewhere on the board
/processor/TIM3_CH1: C107.1, R51.2, SW2.B, U20.56 (PB4)
/processor/TIM3_CH2: C105.1, R50.2, SW2.A, U20.26 (PB0)
/processor/TIM5_CH2: U20.9 (PC1); also elsewhere on the board
/processor/TIM5_ETR: U20.8 (PC0); also elsewhere on the board
/processor/USB_DM: R43.1, U20.44 (PA11)
/processor/USB_DP: R42.1, R44.2, U20.45 (PA12)
/ref_input_output/ctr_0: U20.54 (PD2); also elsewhere on the board
/ref_input_output/ctr_1: U20.52 (PC11); also elsewhere on the board
GND: C95.2, C96.2, C97.2, C98.1, C99.2, C100.2, C101.2, C102.2, C103.2, C104.2, C105.2, C106.2, C107.2, C108.2, C109.2, D12.1 (K), J5.4 (ID), J5.5 (GND), J6.4, R45.2, R47.2, SW2.C, SW2.S2, U19.4 (GND), U20.12 (VSSA), U20.31 (VSSSD), U20.63 (VSS), U21.1 (GND), U22.2 (GND); also elsewhere on the board
unnamed: C95.1, U19.5 (Trim/NR)
unnamed: C96.1, U20.5 (PF0), Y1.1
unnamed: C97.1, U20.6 (PF1), Y1.2
unnamed: C98.2, R48.2, U20.7 (NRST)
unnamed: C109.1, R53.2, SW2.S1
unnamed: D12.2 (A), R52.2
unnamed: J5.2 (D-), R43.2
unnamed: J5.3 (D+), R42.2
unnamed: JP1.2, R47.1, U20.60 (BOOT0)
unnamed: R49.2, U22.8 (LED)
unnamed: U20.23 (PA7), U22.9 (MISO)

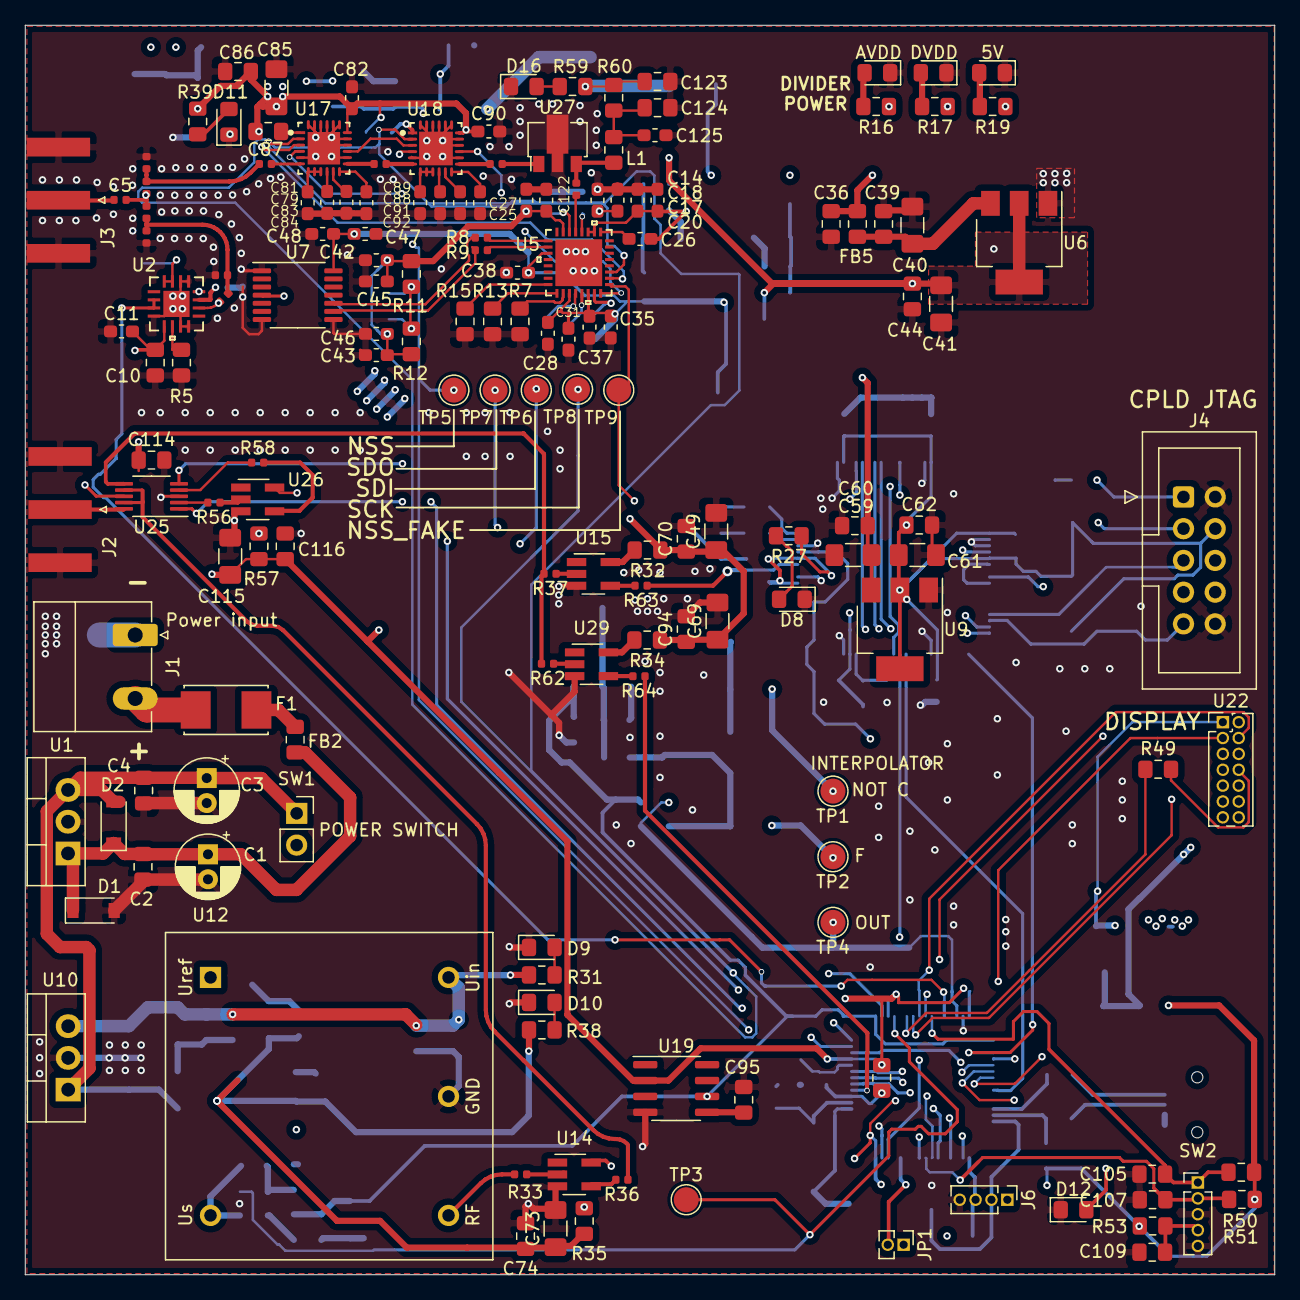
[picture p30: board FrequencyCounter.kicad_pcb from above]

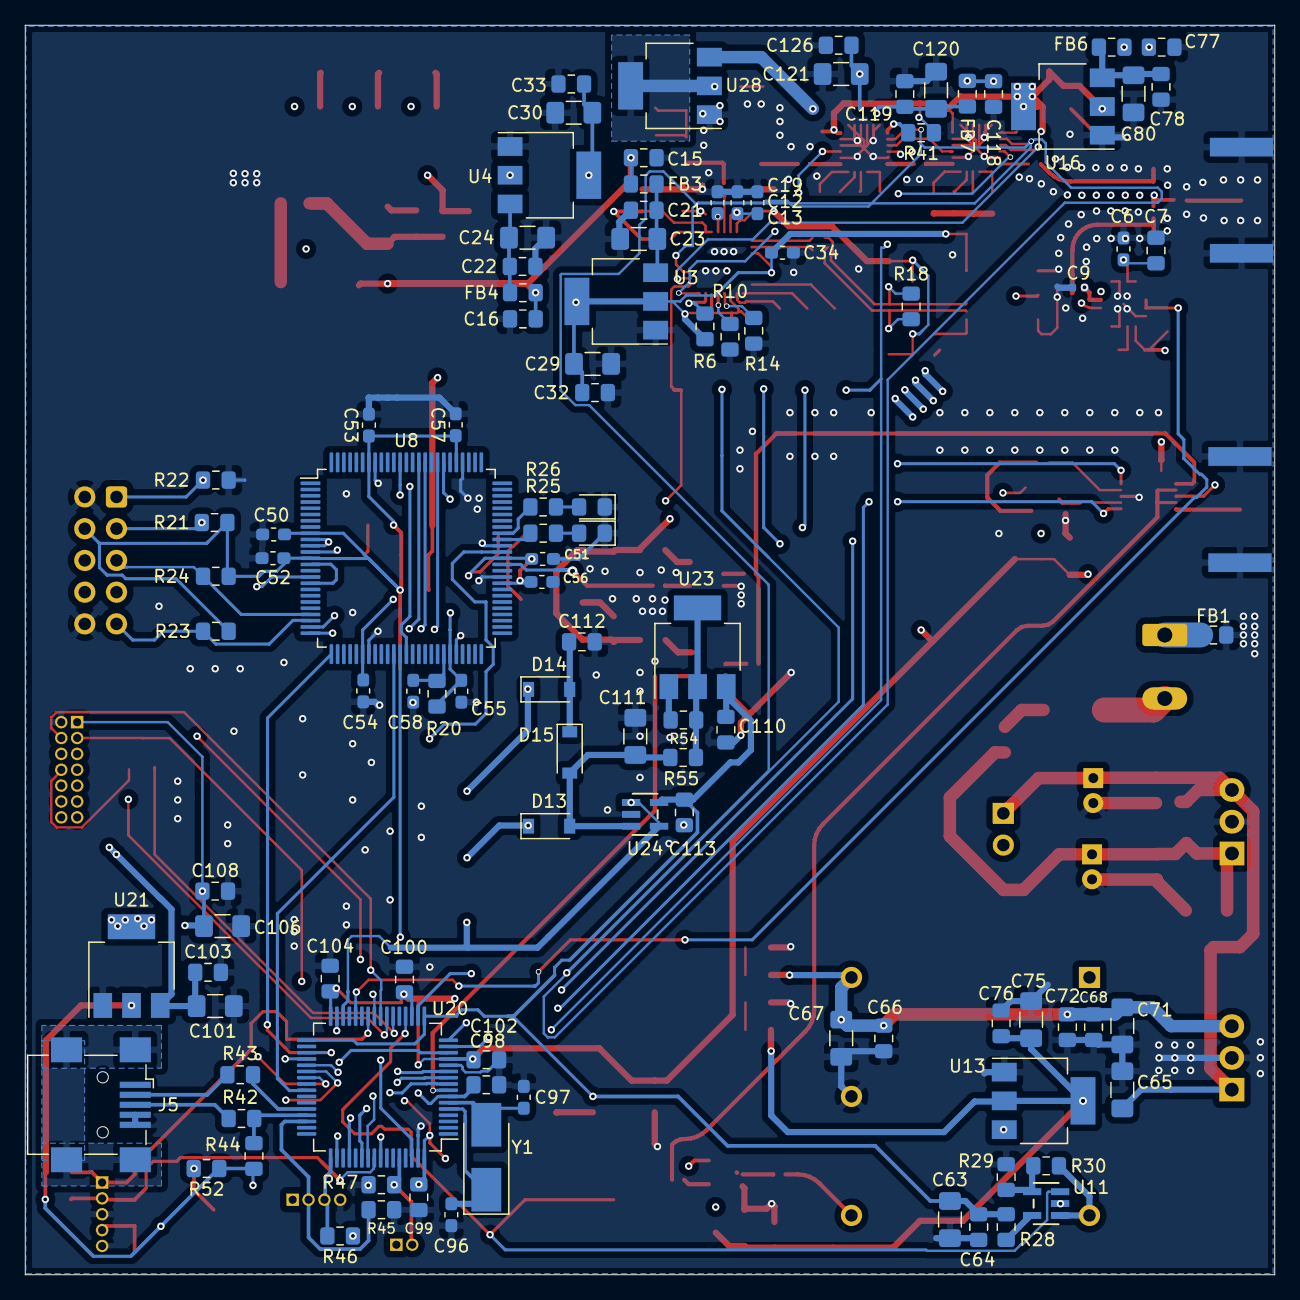
[picture p31: board FrequencyCounter.kicad_pcb from below]

Board: 4 copper layers, 100.0 x 100.0 mm, 263 parts (106 on the bottom side), 150 nets.
